synthkore/drivepackhw/CartHeader/CartHeader.kicad_pcb

## KiCad design CartHeader/CartHeader.kicad_pcb (2023-12-17)

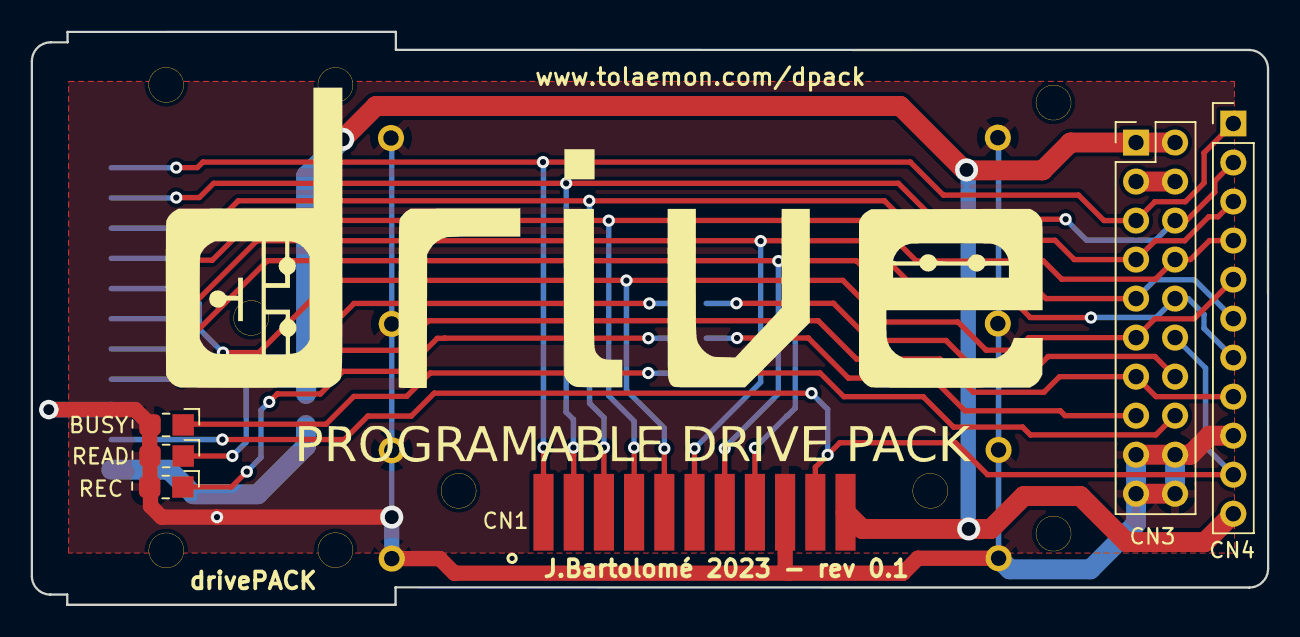
[picture p1: board CartHeader.kicad_pcb from above]

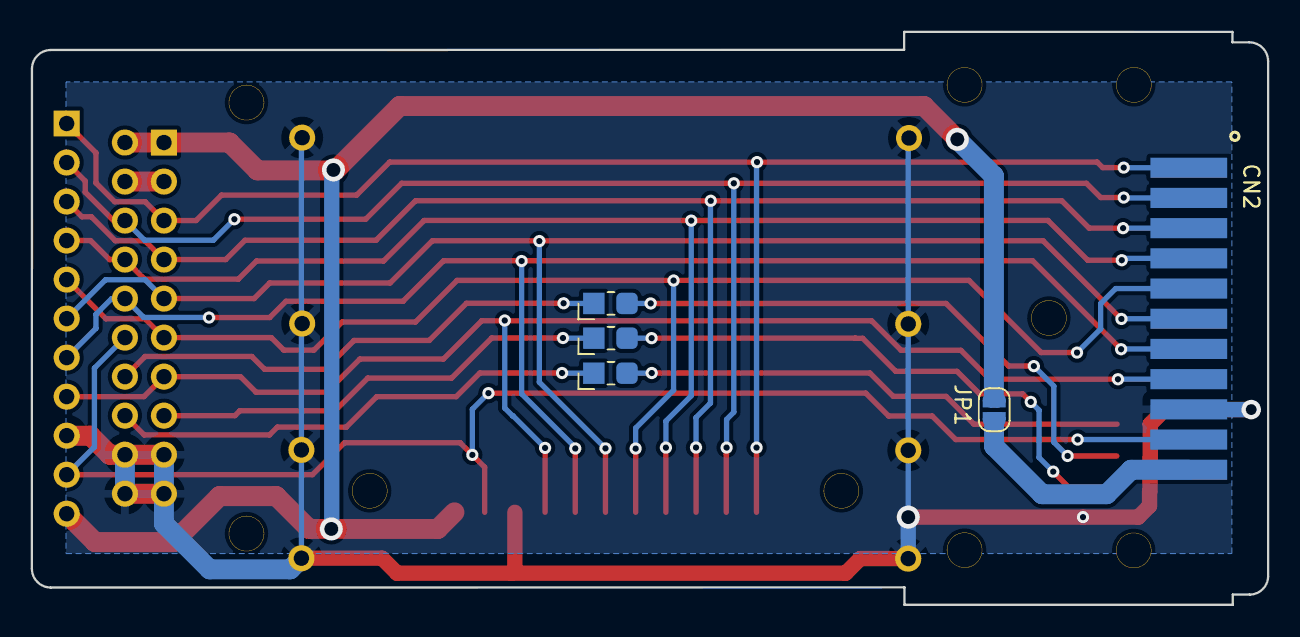
[picture p2: board CartHeader.kicad_pcb from below]

Board: 2 copper layers, 80.5 x 37.3 mm, 28 parts (5 on the bottom side), 19 nets.

Parts:
BUSY: LD; SMD_LD_0805_2012Metric
CN1: dumper connector; DrivePackHeaderFemale
CN2: drivePACKconnector; DrivePackHeaderMale
CN3: PinStrip2x10; PinHeader_2x10_P2.54mm_Vertical
CN4: PinStrip11; PinHeader_1x11_P2.54mm_Vertical
CN5, CN6, CN7, CN8, CN9, CN10, CN11, CN12: Pin; PinPad_1x01_P2.54mm_Round
JP1: Jumper; SolderJumper-2_P1.3mm_Open_RoundedPad1.0x1.5mm
MH1, MH2, MH3, MH4, MH5, MH6, MH7, MH8, MH9: MountingHole; MHole_2_25
R1, R2, R3: 150; SMD_R_0805_2012Metric
READ: LD; SMD_LD_0805_2012Metric
REC: LD; SMD_LD_0805_2012Metric

Connections:
/!CS: CN1.10 (nCS), CN2.10 (nCS), CN3.12, CN4.10
/!D0: CN1.4 (nD0), CN2.4 (nD0), CN3.8, CN4.4
/!D1: CN1.3 (nD1), CN2.3 (nD1), CN3.7, CN4.3
/!D2: CN1.2 (nD2), CN2.2 (nD2), CN3.6, CN4.2
/!D3: CN1.1 (nD3), CN2.1 (nD3), CN3.5, CN4.1
/!W\R: CN1.5 (RnW), CN2.5 (RnW), CN3.11, CN4.5
/?: CN1.8 (?), CN2.8 (?), CN3.13, CN4.8
/CLCK1: CN1.6 (CLK1), CN2.6 (CLK1), CN3.9, CN4.6
/CLCK2: CN1.7 (CLK2), CN2.7 (CLK2), CN3.10, CN4.7
/ROM_IO1: CN3.14, R1.1
/ROM_IO2: CN3.15, R2.1
/ROM_IO3: CN3.16, R3.1
GND: BUSY.2, CN1.9 (GND), CN2.9 (GND), CN3.17, CN3.18, CN3.19, CN3.20, CN4.9, CN5.1, CN6.1, CN7.1, CN8.1, CN9.1, CN10.1, CN11.1, CN12.1, READ.2, REC.2
unnamed: CN2.11 (Vcc), JP1.1
unnamed: R1.2, READ.1
unnamed: R2.2, REC.1
unnamed: BUSY.1, R3.2
VCC3.3: CN3.3, CN3.4
VCC5: CN1.11 (Vcc), CN3.1, CN3.2, CN4.11, JP1.2
