synthkore/drivepackhw/BaseBoard/BaseBoard.kicad_pcb

## KiCad design BaseBoard/BaseBoard.kicad_pcb (2023-12-17)

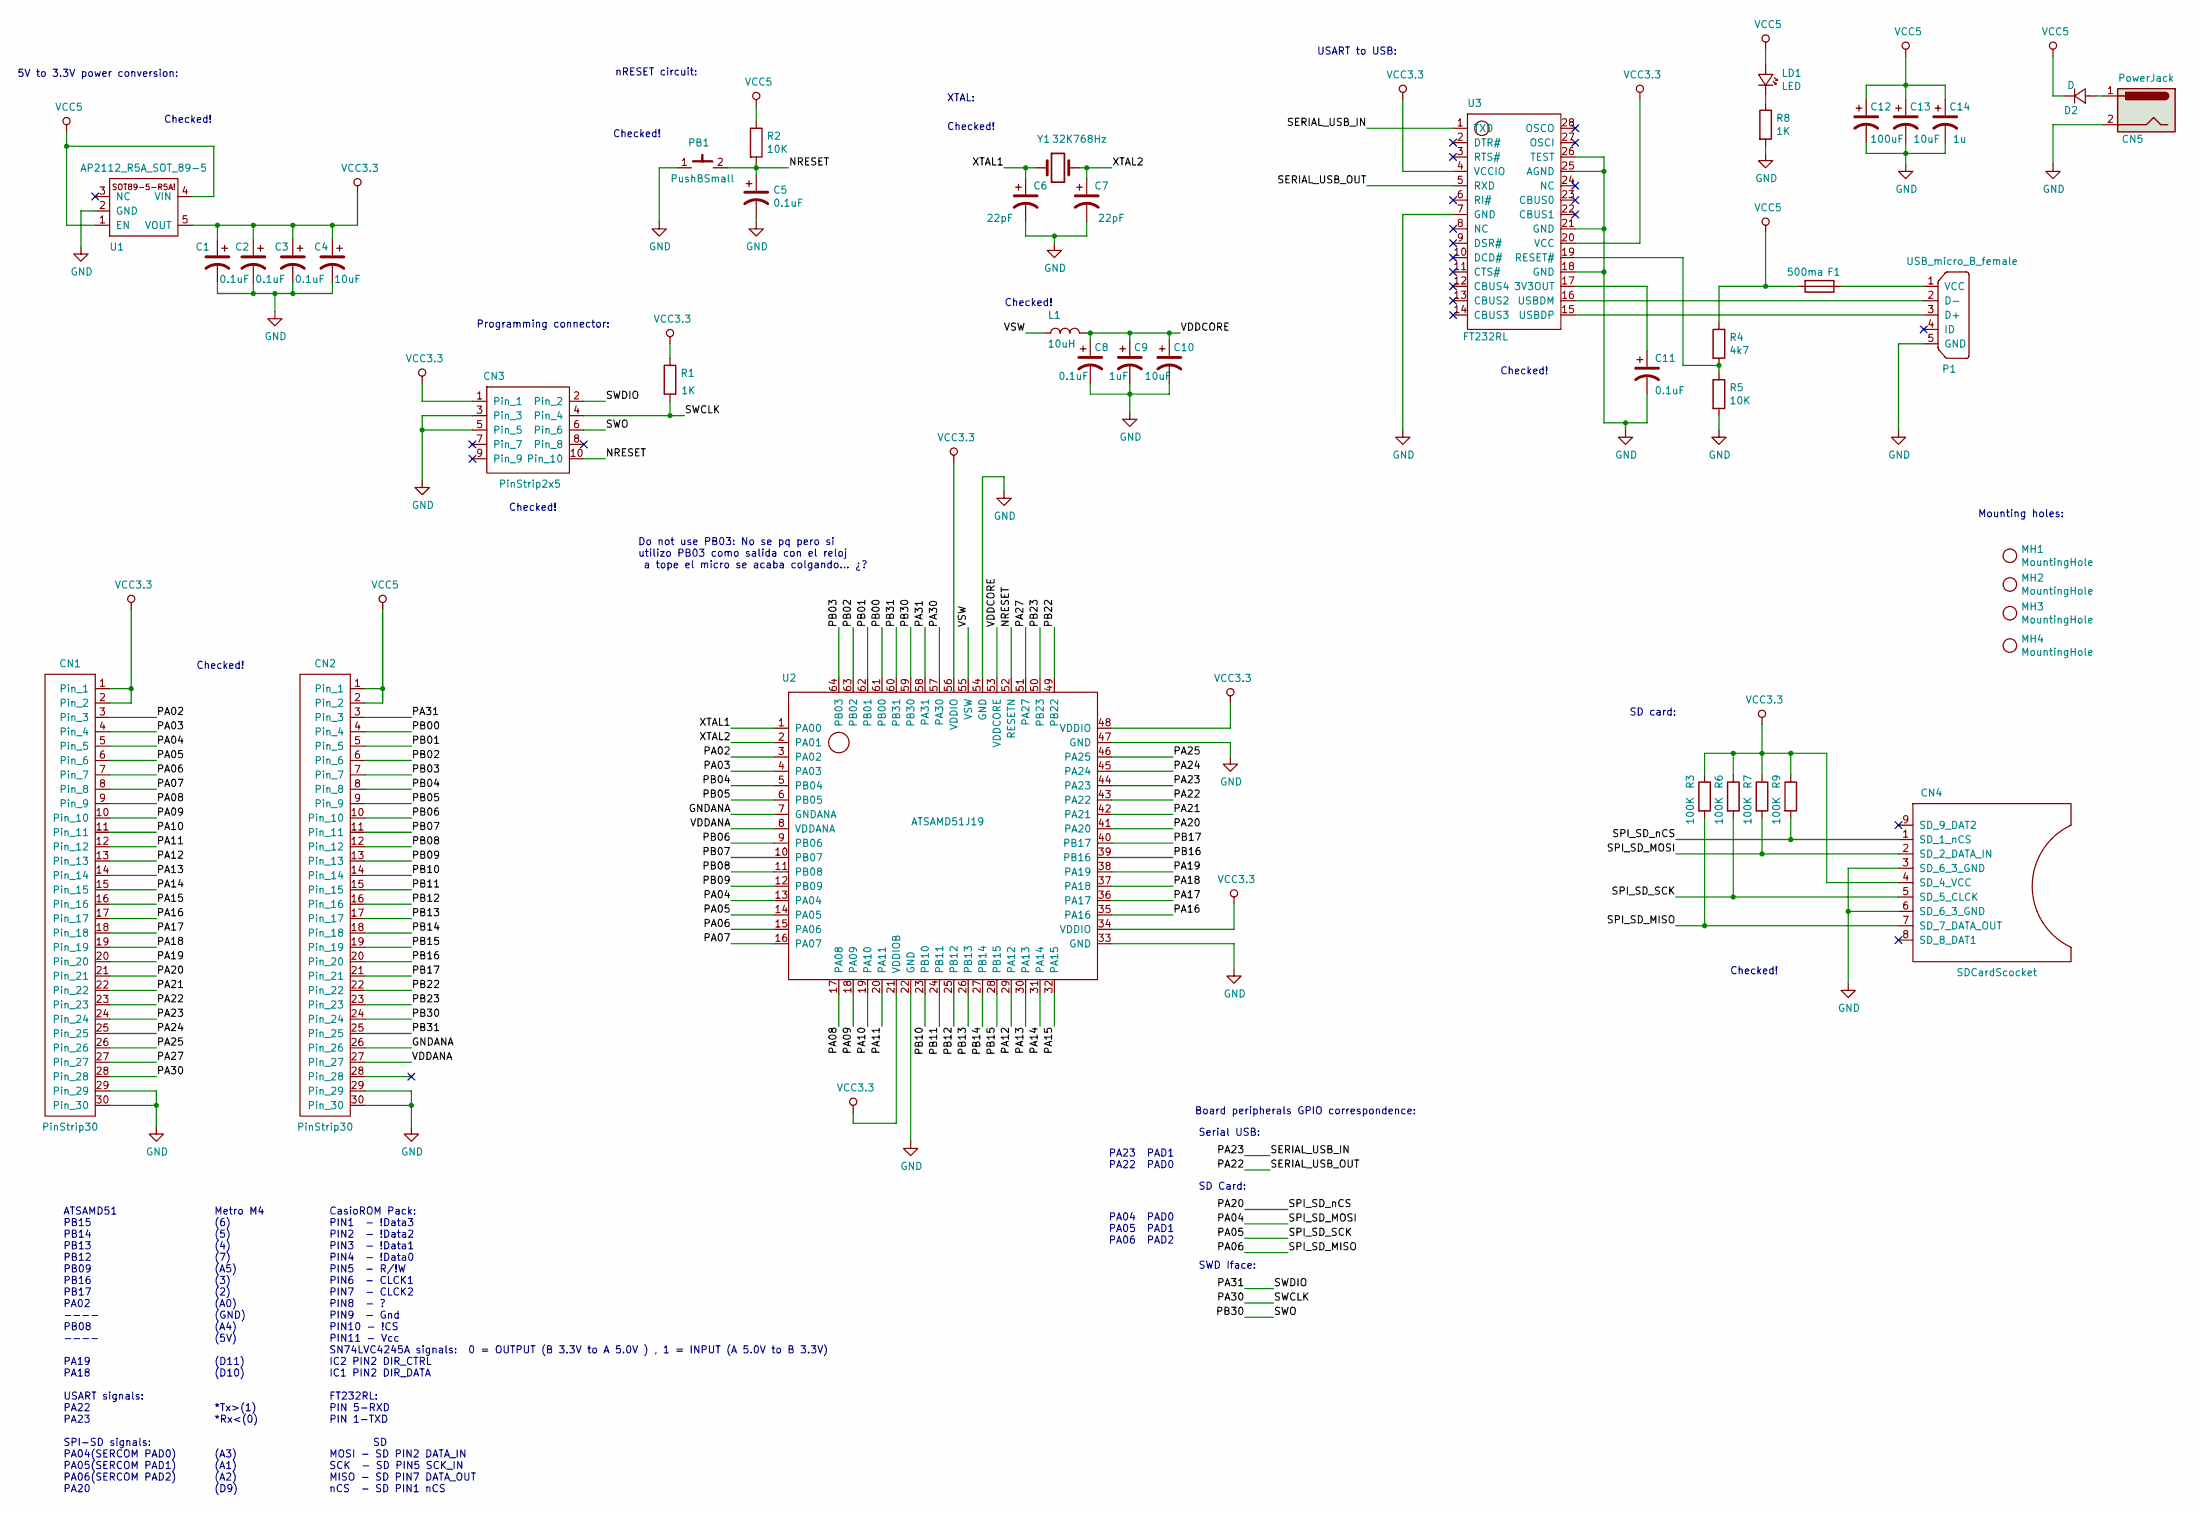
[picture p3: schematic BaseBoard.kicad_sch, bareSAM development board]

Parts:
C1, C2, C3, C5, C8, C11: 0.1uF; SMD_C_0805_2012Metric
C4, C10, C13: 10uF; SMD_C_0.5x0.5cm
C6, C7: 22pF; SMD_C_0805_2012Metric
C9: 1uF; SMD_C_0.5x0.5cm
C12: 100uF; SMD_C_0.5x0.5cm
C14: 1u; SMD_C_0.5x0.5cm
CN1, CN2: PinStrip30; PinHeader_1x30_P2.54mm_Vertical
CN3: PinStrip2x5; PinHeader_2x05_P2.54mm_Vertical
CN4: SDCardScocket; SDCard_NoHoles
CN5: PowerJack; PowerFemale
D2: D; D_SOD-123
F1: 500ma; SMD_C_0805_2012Metric
L1: 10uH; SMD_L_4018
LD1: LED; SMD_LD_0805_2012Metric
MH1, MH2, MH3, MH4: MountingHole
P1: USB_micro_B_female; USB_Micro-B_Wuerth_629105150521
PB1: PushBSmall; PushButton
R1, R8: 1K; SMD_R_0805_2012Metric
R2, R5: 10K; SMD_R_0805_2012Metric
R3, R6, R7, R9: 100K; SMD_R_0805_2012Metric
R4: 4k7; SMD_R_0805_2012Metric
U1: AP2112_R5A_SOT_89-5; SOT-89-5_Handsoldering
U2: ATSAMD51J19; TQFP-64-1EP_10x10mm_P0.5mm_EP8x8mm
U3: FT232RL; SSOP-28_5.3x10.2mm_P0.65mm
Y1: 32K768Hz; SMD_XTAL_3.4x2.7max

Connections:
/GNDANA: CN2.26, U2.7 (GNDANA)
/NRESET: C5.1, CN3.10, PB1.2, R2.2, U2.52 (RESETN)
/PA02: CN1.3, U2.3 (PA02)
/PA03: CN1.4, U2.4 (PA03)
/PA04: CN1.5, CN4.2 (SD_2_DATA_IN), R7.2, U2.13 (PA04)
/PA05: CN1.6, CN4.5 (SD_5_CLCK), R6.2, U2.14 (PA05)
/PA06: CN1.7, CN4.7 (SD_7_DATA_OUT), R3.2, U2.15 (PA06)
/PA07: CN1.8, U2.16 (PA07)
/PA08: CN1.9, U2.17 (PA08)
/PA09: CN1.10, U2.18 (PA09)
/PA10: CN1.11, U2.19 (PA10)
/PA11: CN1.12, U2.20 (PA11)
/PA12: CN1.13, U2.29 (PA12)
/PA13: CN1.14, U2.30 (PA13)
/PA14: CN1.15, U2.31 (PA14)
/PA15: CN1.16, U2.32 (PA15)
/PA16: CN1.17, U2.35 (PA16)
/PA17: CN1.18, U2.36 (PA17)
/PA18: CN1.19, U2.37 (PA18)
/PA19: CN1.20, U2.38 (PA19)
/PA20: CN1.21, CN4.1 (SD_1_nCS), R9.2, U2.41 (PA20)
/PA21: CN1.22, U2.42 (PA21)
/PA22: CN1.23, U2.43 (PA22), U3.5 (RXD)
/PA23: CN1.24, U2.44 (PA23), U3.1 (TXD)
/PA24: CN1.25, U2.45 (PA24)
/PA25: CN1.26, U2.46 (PA25)
/PA27: CN1.27, U2.51 (PA27)
/PA30: CN1.28, CN3.4, R1.2, U2.57 (PA30)
/PA31: CN2.3, CN3.2, U2.58 (PA31)
/PB00: CN2.4, U2.61 (PB00)
/PB01: CN2.5, U2.62 (PB01)
/PB02: CN2.6, U2.63 (PB02)
/PB03: CN2.7, U2.64 (PB03)
/PB04: CN2.8, U2.5 (PB04)
/PB05: CN2.9, U2.6 (PB05)
/PB06: CN2.10, U2.9 (PB06)
/PB07: CN2.11, U2.10 (PB07)
/PB08: CN2.12, U2.11 (PB08)
/PB09: CN2.13, U2.12 (PB09)
/PB10: CN2.14, U2.23 (PB10)
/PB11: CN2.15, U2.24 (PB11)
/PB12: CN2.16, U2.25 (PB12)
/PB13: CN2.17, U2.26 (PB13)
/PB14: CN2.18, U2.27 (PB14)
/PB15: CN2.19, U2.28 (PB15)
/PB16: CN2.20, U2.39 (PB16)
/PB17: CN2.21, U2.40 (PB17)
/PB22: CN2.22, U2.49 (PB22)
/PB23: CN2.23, U2.50 (PB23)
/PB30: CN2.24, CN3.6, U2.59 (PB30)
/PB31: CN2.25, U2.60 (PB31)
/VDDANA: CN2.27, U2.8 (VDDANA)
/VDDCORE: C8.1, C9.1, C10.1, L1.1, U2.53 (VDDCORE)
/VSW: L1.2, U2.55 (VSW)
/XTAL1: C6.1, U2.1 (PA00), Y1.1
/XTAL2: C7.1, U2.2 (PA01), Y1.2
GND: C1.2, C2.2, C3.2, C4.2, C5.2, C6.2, C7.2, C8.2, C9.2, C10.2, C11.2, C12.2, C13.2, C14.2, CN1.29, CN1.30, CN2.29, CN2.30, CN3.3, CN3.5, CN4.3 (SD_6_3_GND), CN4.6 (SD_6_3_GND), CN5.2, P1.5 (GND), PB1.1, R5.2, R8.2, U1.2 (GND), U2.22 (GND), U2.33 (GND), U2.47 (GND), U2.54 (GND), U3.7 (GND), U3.18 (GND), U3.21 (GND), U3.25 (AGND), U3.26 (TEST)
unnamed: C11.1, U3.17 (3V3OUT)
unnamed: CN5.1, D2.1
unnamed: F1.1, P1.1 (VCC)
unnamed: LD1.2, R8.1
unnamed: P1.2 (D-), U3.16 (USBDM)
unnamed: P1.3 (D+), U3.15 (USBDP)
unnamed: R4.2, R5.1, U3.19 (RESET#)
VCC3.3: C1.1, C2.1, C3.1, C4.1, CN1.1, CN1.2, CN3.1, CN4.4 (SD_4_VCC), R1.1, R3.1, R6.1, R7.1, R9.1, U1.5 (VOUT), U2.21 (VDDIOB), U2.34 (VDDIO), U2.48 (VDDIO), U2.56 (VDDIO), U3.4 (VCCIO), U3.20 (VCC)
VCC5: C12.1, C13.1, C14.1, CN2.1, CN2.2, D2.2, F1.2, LD1.1, R2.1, R4.1, U1.1 (EN), U1.4 (VIN)

Notes on the sheet:
XTAL:
PA04 PAD0 PA05 PAD1 PA06 PAD2
Do not use PB03: No se pq pero si utilizo PB03 como salida con el reloj a tope el micro se acaba colgando... ¿?
Mounting holes:
Checked!
Metro M4 (6) (5) (4) (7) (A5) (3) (2) (A0) (GND) (A4) (5V) (D11) (D10) *Tx>(1) *Rx<(0) (A3) (A1) (A2) (D9)
CasioROM Pack: PIN1 - !Data3 PIN2 - !Data2 PIN3 - !Data1 PIN4 - !Data0 PIN5 - R/!W PIN6 - CLCK1 PIN7 - CLCK2 PIN8 - ? PIN9 - Gnd PIN10 - !CS PIN11 - Vcc SN74LVC4245A signals: 0 = OUTPUT (B 3.3V to A 5.0V ) , 1 = INPUT (A 5.0V to B 3.3V) IC2 PIN2 DIR_CTRL IC1 PIN2 DIR_DATA FT232RL: PIN 5-RXD PIN 1-T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
Board peripherals GPIO correspondence:
5V to 3.3V power conversion:
SWD Iface:
PA23 PAD1 PA22 PAD0
Serial USB:
USART to USB:
Programming connector:
SD Card:
ATSAMD51 PB15 PB14 PB13 PB12 PB09 PB16 PB17 PA02 ---- PB08 ---- PA19 PA18 USART signals: PA22 PA23 SPI-SD signals: PA04(SERCOM PAD0) PA05(SERCOM PAD1) PA06(SERCOM PAD2) PA20
nRESET circuit:
SD card:

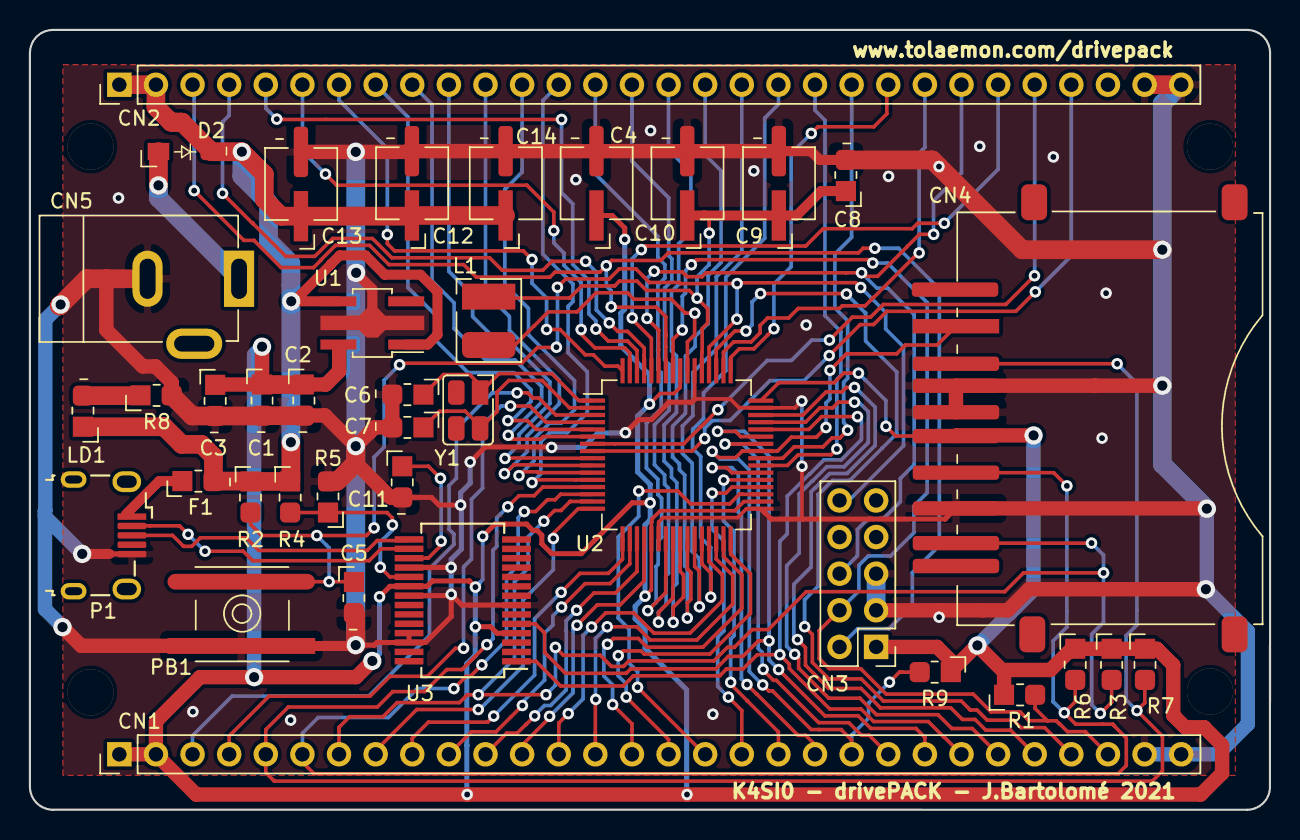
[picture p4: board BaseBoard.kicad_pcb from above]

Board: 2 copper layers, 86.0 x 54.1 mm, 42 parts (0 on the bottom side), 66 nets.
