synthkore/drivepackhw/HatBoard/HatBoard.kicad_pcb

## KiCad design HatBoard/HatBoard.kicad_pcb (2023-12-17)

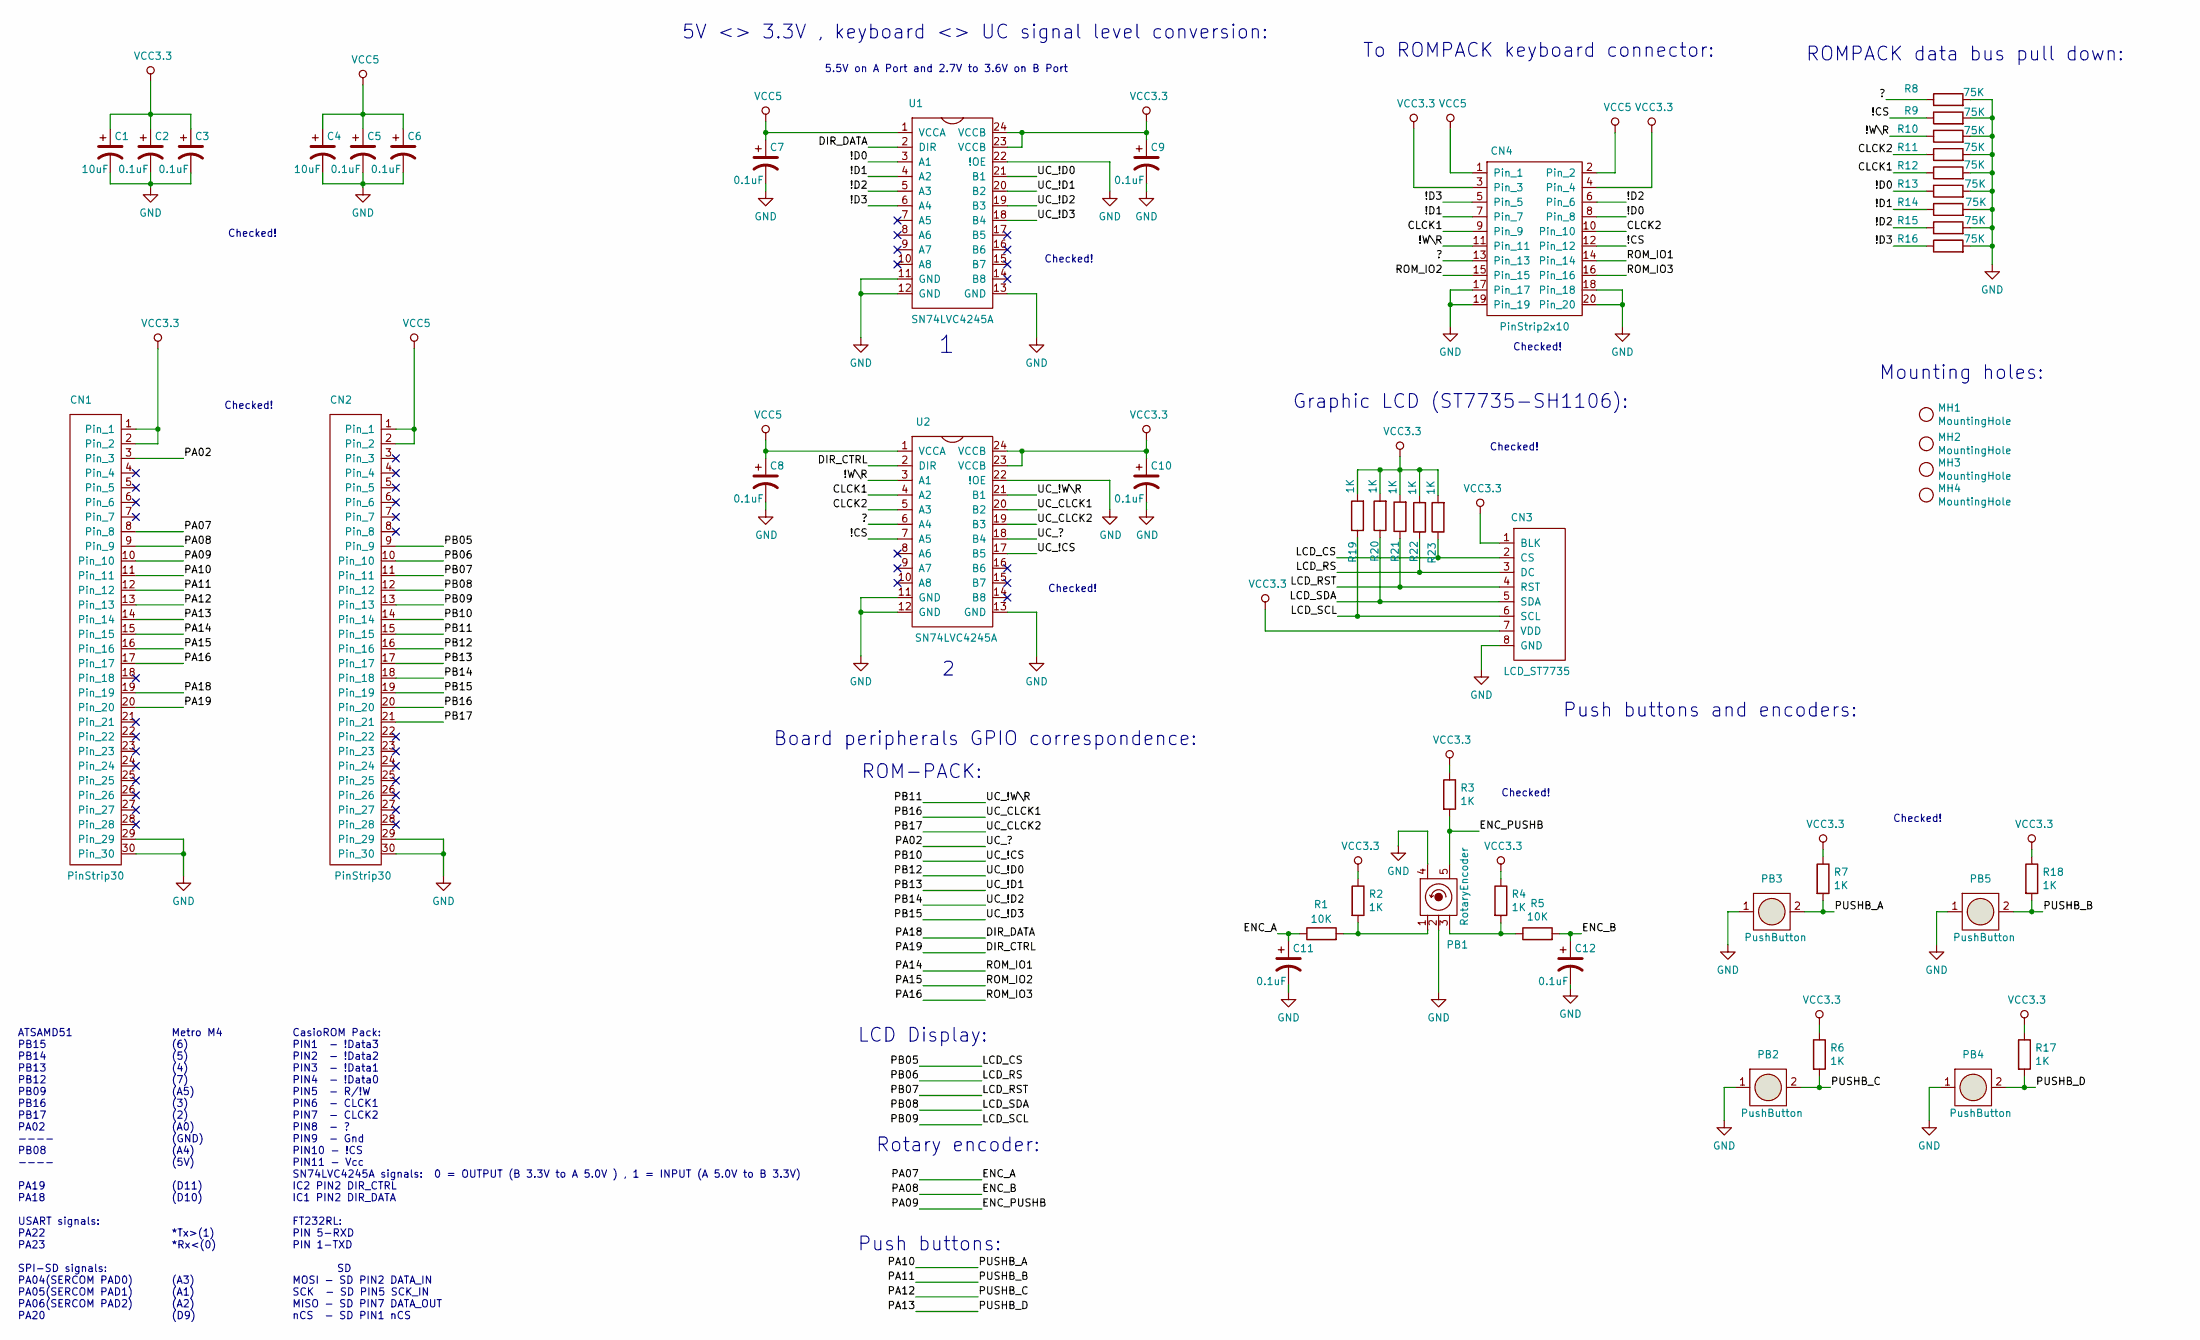
[picture p5: schematic HatBoard.kicad_sch, drive Pack main unit hat board]

Parts:
C1, C4: 10uF; SMD_C_0.5x0.5cm
C2, C3, C5, C6, C7, C8, C9, C10, C11, C12: 0.1uF; SMD_C_0805_2012Metric
CN1, CN2: PinStrip30; PinHeader_1x30_P2.54mm_Vertical
CN3: LCD_ST7735
CN4: PinStrip2x10; PinHeader_2x10_P2.54mm_Vertical
MH1, MH2, MH3, MH4: MountingHole
PB1: RotaryEncoder; EncoderPushButton
PB2, PB3, PB4, PB5: PushButton; PushButtonBig
R1, R5: 10K; SMD_R_0805_2012Metric
R2, R3, R4, R6, R7, R17, R18, R19, R20, R21, R22, R23: 1K; SMD_R_0805_2012Metric
R8, R9, R10, R11, R12, R13, R14, R15, R16: 75K; SMD_R_0805_2012Metric
U1, U2: SN74LVC4245A; SSOP-24_5.3x8.2mm_P0.65mm

Connections:
/!CS: CN4.12, R9.1, U2.7 (A5)
/!D0: CN4.8, R13.1, U1.3 (A1)
/!D1: CN4.7, R14.1, U1.4 (A2)
/!D2: CN4.6, R15.1, U1.5 (A3)
/!D3: CN4.5, R16.1, U1.6 (A4)
/!W\R: CN4.11, R10.1, U2.3 (A1)
/?: CN4.13, R8.1, U2.6 (A4)
/CLCK1: CN4.9, R12.1, U2.4 (A2)
/CLCK2: CN4.10, R11.1, U2.5 (A3)
/DIR_CTRL: CN1.20, U2.2 (DIR)
/DIR_DATA: CN1.19, U1.2 (DIR)
/ENC_A: C11.1, CN1.8, R1.1
/ENC_B: C12.1, CN1.9, R5.2
/ENC_PUSHB: CN1.10, PB1.5, R3.2
/LCD_CS: CN2.9, CN3.2 (CS), R23.1
/LCD_RS: CN2.10, CN3.3 (DC), R22.1
/LCD_RST: CN2.11, CN3.4 (RST), R21.1
/LCD_SCL: CN2.13, CN3.6 (SCL), R19.1
/LCD_SDA: CN2.12, CN3.5 (SDA), R20.1
/PA02: CN1.3, U2.18 (B4)
/PA10: CN1.11, PB3.2, R7.2
/PA11: CN1.12, PB5.2, R18.2
/PA12: CN1.13, PB2.2, R6.2
/PA13: CN1.14, PB4.2, R17.2
/PA14: CN1.15, CN4.14
/PA15: CN1.16, CN4.15
/PA16: CN1.17, CN4.16
/PB10: CN2.14, U2.17 (B5)
/PB11: CN2.15, U2.21 (B1)
/PB12: CN2.16, U1.21 (B1)
/PB13: CN2.17, U1.20 (B2)
/PB14: CN2.18, U1.19 (B3)
/PB15: CN2.19, U1.18 (B4)
/PB16: CN2.20, U2.20 (B2)
/PB17: CN2.21, U2.19 (B3)
GND: C1.2, C2.2, C3.2, C4.2, C5.2, C6.2, C7.2, C8.2, C9.2, C10.2, C11.2, C12.2, CN1.29, CN1.30, CN2.29, CN2.30, CN3.8 (GND), CN4.17, CN4.18, CN4.19, CN4.20, PB1.2, PB1.4, PB2.1, PB3.1, PB4.1, PB5.1, R8.2, R9.2, R10.2, R11.2, R12.2, R13.2, R14.2, R15.2, R16.2, U1.11 (GND), U1.12 (GND), U1.13 (GND), U1.22 (!OE), U2.11 (GND), U2.12 (GND), U2.13 (GND), U2.22 (!OE)
unnamed: PB1.1, R1.2, R2.2
unnamed: PB1.3, R4.2, R5.1
VCC3.3: C1.1, C2.1, C3.1, C9.1, C10.1, CN1.1, CN1.2, CN3.1 (BLK), CN3.7 (VDD), CN4.3, CN4.4, R2.1, R3.1, R4.1, R6.1, R7.1, R17.1, R18.1, R19.2, R20.2, R21.2, R22.2, R23.2, U1.23 (VCCB), U1.24 (VCCB), U2.23 (VCCB), U2.24 (VCCB)
VCC5: C4.1, C5.1, C6.1, C7.1, C8.1, CN2.1, CN2.2, CN4.1, CN4.2, U1.1 (VCCA), U2.1 (VCCA)

Notes on the sheet:
LCD Display:
Checked!
Metro M4 (6) (5) (4) (7) (A5) (3) (2) (A0) (GND) (A4) (5V) (D11) (D10) *Tx>(1) *Rx<(0) (A3) (A1) (A2) (D9)
ROM-PACK:
Rotary encoder:
Push buttons and encoders:
Board peripherals GPIO correspondence:
Mounting holes:
CasioROM Pack: PIN1 - !Data3 PIN2 - !Data2 PIN3 - !Data1 PIN4 - !Data0 PIN5 - R/!W PIN6 - CLCK1 PIN7 - CLCK2 PIN8 - ? PIN9 - Gnd PIN10 - !CS PIN11 - Vcc SN74LVC4245A signals: 0 = OUTPUT (B 3.3V to A 5.0V ) , 1 = INPUT (A 5.0V to B 3.3V) IC2 PIN2 DIR_CTRL IC1 PIN2 DIR_DATA FT232RL: PIN 5-RXD PIN 1-T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
Graphic LCD (ST7735-SH1106):
ROMPACK data bus pull down:
To ROMPACK keyboard connector:
5V <> 3.3V , keyboard <> UC signal level conversion:
ATSAMD51 PB15 PB14 PB13 PB12 PB09 PB16 PB17 PA02 ---- PB08 ---- PA19 PA18 USART signals: PA22 PA23 SPI-SD signals: PA04(SERCOM PAD0) PA05(SERCOM PAD1) PA06(SERCOM PAD2) PA20
Push buttons:
5.5V on A Port and 2.7V to 3.6V on B Port

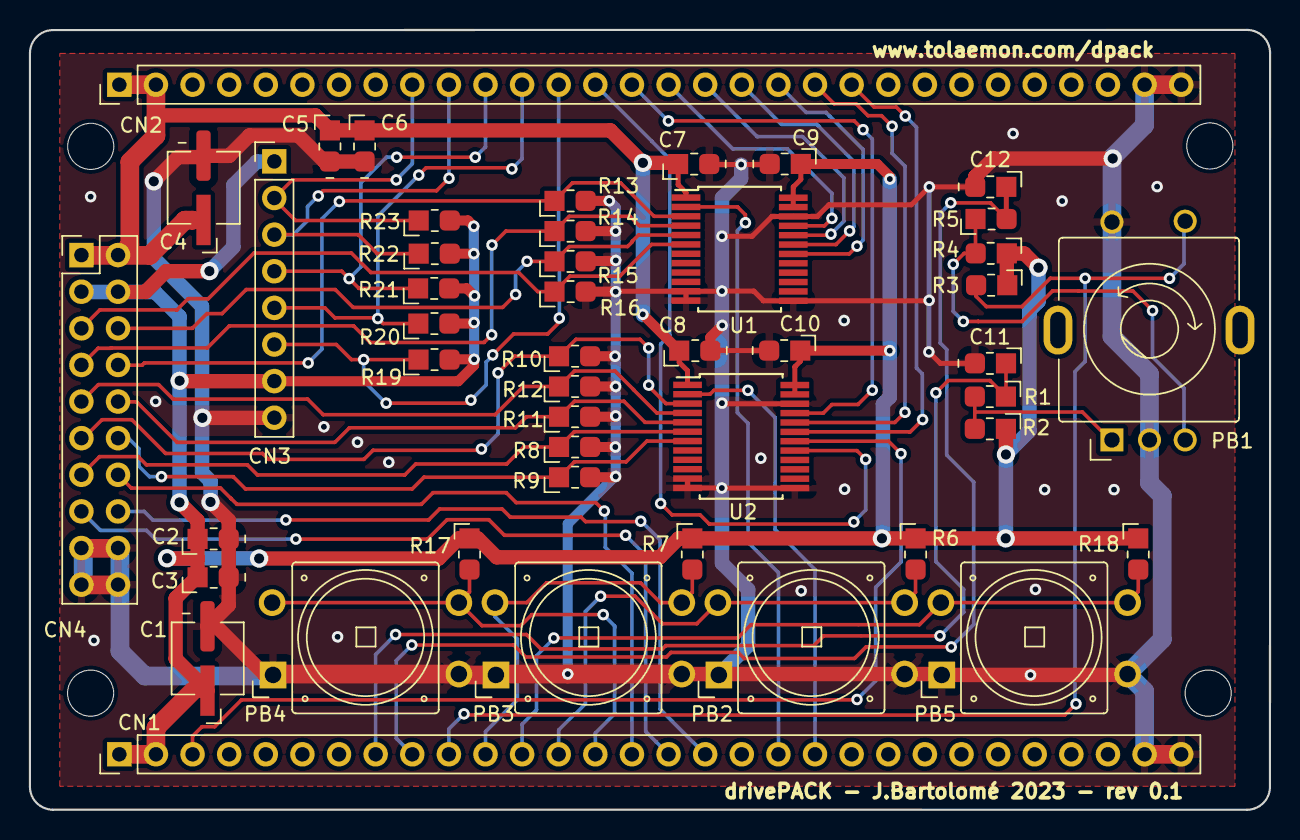
[picture p6: board HatBoard.kicad_pcb from above]

Board: 2 copper layers, 86.0 x 54.1 mm, 50 parts (0 on the bottom side), 40 nets.
