synthkore/drivepackhw/(threads)

Thread 1 (2025-04-02):

Mechanical part of the read write head

whc2001, 2025-04-02:
Could you please also share the design of the piece below the read/write head PCB (as shown in the image on the website)  that provides the notch to hold it inside the ROM Pack slot?

synthkore, 2025-04-04:
Done! I've just searched and uploaded to the repository the files of the "cart header base board", the one that is mounted under the cart header board and fits into the keyboard slot. Use a maximum width of 1mm.

whc2001, 2025-04-04:
Awesome! Thanks a lot!

synthkore, 2025-04-04:
You'll need to create a small frame with a 3D printer or laser cutter and use it as a separator between the TOP and the bottom board. Maybe using some sort of spacer would also do the job, I don't know. A distance arround 2.5mm between the who boards is the distance i use. The frames I printed had a small problem that I had to fix by hand with a thin file tool, so I don't have proper 3d printer files to share. Hope to generate ones soon.

The component that was hardest for me to find was the zebra connector. Not just any will do. I eventually got it through a supplier from the company I work at by purchasing a large quantity. If you can't find this component, you can try canibalizin and adapting one from another ROM pack cartridge or some other electronic device (some old LCDs used zebra connectors). And if that doesn't work, you can always solder a connector directly to your keyboard and use a standard male/female connector (that's what I did at first).

whc2001, 2025-04-06:
> You'll need to create a small frame with a 3D printer or laser cutter and use it as a separator between the TOP and the bottom board. Maybe using some sort of spacer would also do the job, I don't know. A distance arround 2.5mm between the who boards is the distance i use. The frames I printed had a small problem that I had to fix by hand with a thin file tool, so I don't have proper 3d printer files to share. Hope to generate ones soon.
>
> The component that was hardest for me to find was the zebra connector. Not just any will do. I eventually got it through a supplier from the company I work at by purchasing a large quantity. If you can't find this component, you can try canibalizin and adapting one from another ROM pack cartridge or some other electronic device (some old LCDs used zebra connectors). And if that doesn't work, you can always solder a connector directly to your keyboard and use a standard male/female connector (that's what I did at first).

I'll look into it after I go back to China and start replicating the unit. The spacer frame should be easy as you have already uploaded the bottom board, I think I can just draw one with Fusion and have it printed really quick. If I ended up doing so I'll upload the design file.

For the rubber strip I can get some standard batch-produced sizes easily (the generic pink one that can be seen in calculators). However the original ROM Pack design is using a T-shaped to prevent slipping from the case, which I don't seem to be able to get any. I do need to consider how do I hold it in place while maintaining pressure to the PCB golden fingers.

synthkore, 2025-08-12:
Very good work, It looks perfect! After reading your issue I realized that the information related to the zebra connector in the project site was not as complete as it should so I decided to create a specific section for that part: [drivePACK zebra connector.](file:///C:/Internet/Tolaemon/dpack/technical.htm#zebra_connector) . This section contains all the important information related to the connector.

Closed 2025-04-04.
