synthkore/drivepackhw/(commit log)

2023-12-17 drivePack revised schematics and PCBs
    [BaseBoard.kicad_pcb, BaseBoard.kicad_sch, BaseBoard.sch, CartHeader.kicad_pcb, CartHeader.kicad_sch, CartHeader.sch, HatBoard.kicad_pcb, HatBoard.kicad_sch]
2024-01-06 Added JTAG to SWD equivalence in BaseBoard schematics
    [BaseBoard.kicad_sch]
2025-04-04 Added the header base board to the repository.
    [CartHeaderBase-B_Cu.gbr, CartHeaderBase-B_Mask.gbr, CartHeaderBase-B_Silkscreen.gbr, CartHeaderBase-Edge_Cuts.gbr, CartHeaderBase-F_Cu.gbr, CartHeaderBase-F_Mask.gbr, CartHeaderBase-F_Silkscreen.gbr, CartHeaderBase-NPTH.drl]
2025-04-04 Minor corrections in the comments.
    [CartHeaderBase.kicad_pcb]
